adirsingh96/open-pendant/docs/cad/xiao_bottom_silkscreen.png

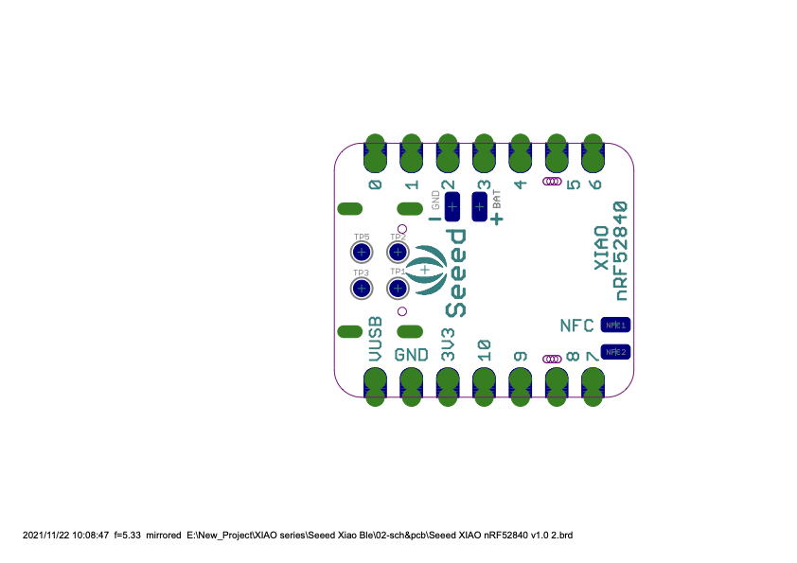
docs/cad/xiao_bottom_silkscreen.png
