adirsingh96/open-pendant/docs/img/proto-bat-window.jpg

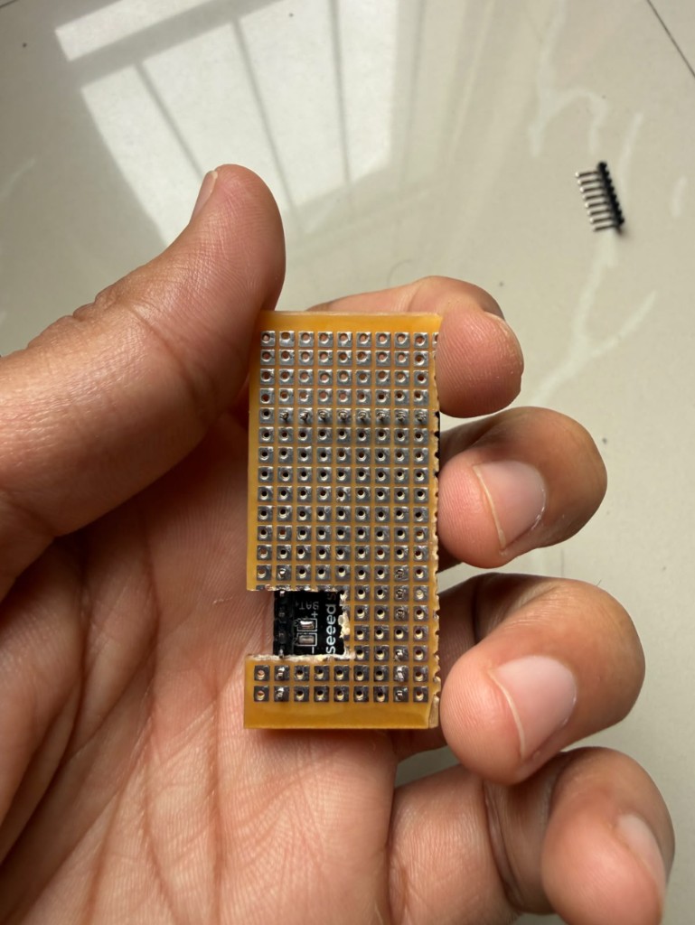
docs/img/proto-bat-window.jpg
