adirsingh96/open-pendant/docs/img/proto-front.jpg

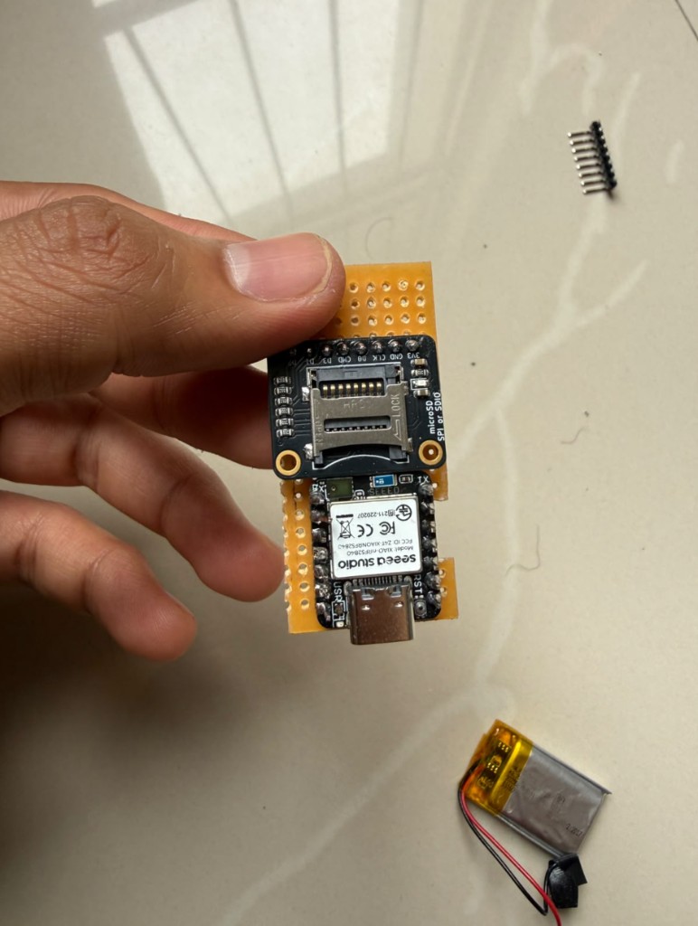
docs/img/proto-front.jpg
