adirsingh96/open-pendant/docs/img/proto-lipo.jpg

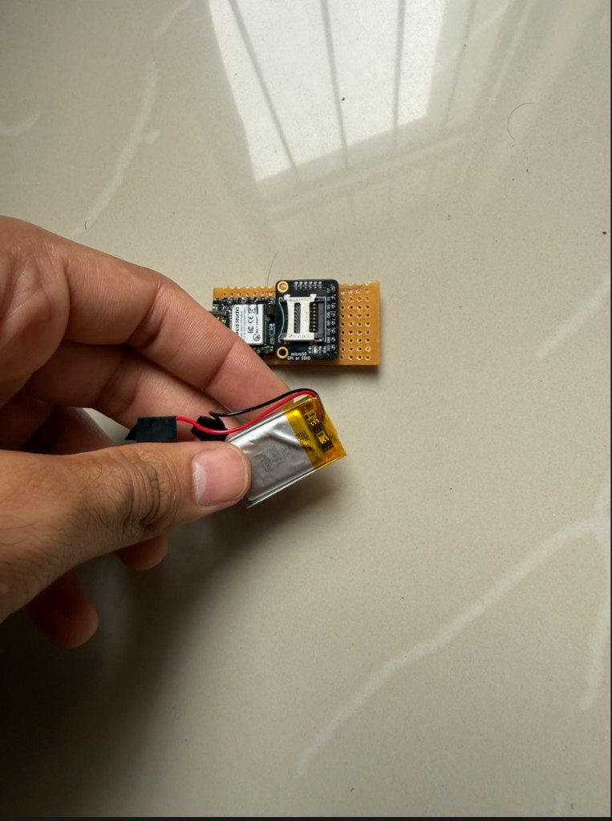
docs/img/proto-lipo.jpg
