adirsingh96/open-pendant/docs/launch/poster.jpg

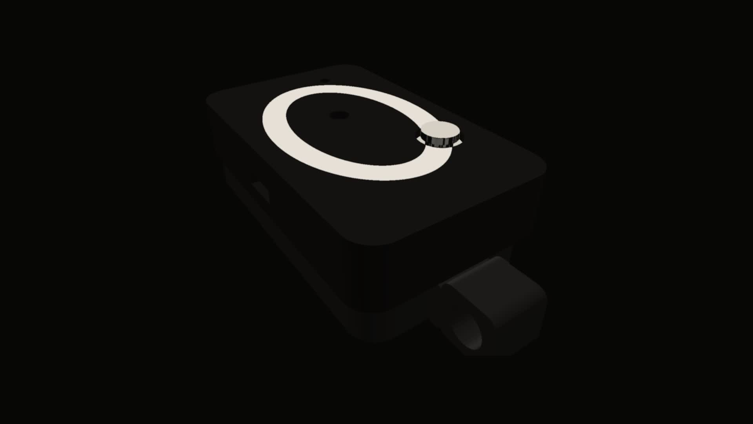
docs/launch/poster.jpg
