adirsingh96/open-pendant/hardware/openpendant_carrier/openpendant_carrier/output/back.png

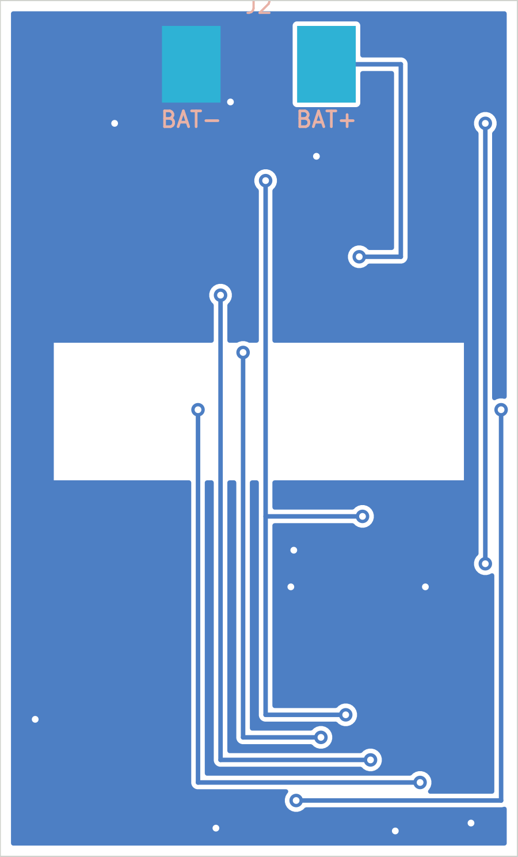
hardware/openpendant_carrier/openpendant_carrier/output/back.png
