adirsingh96/open-pendant/hardware/openpendant_carrier/openpendant_carrier/output/front.png

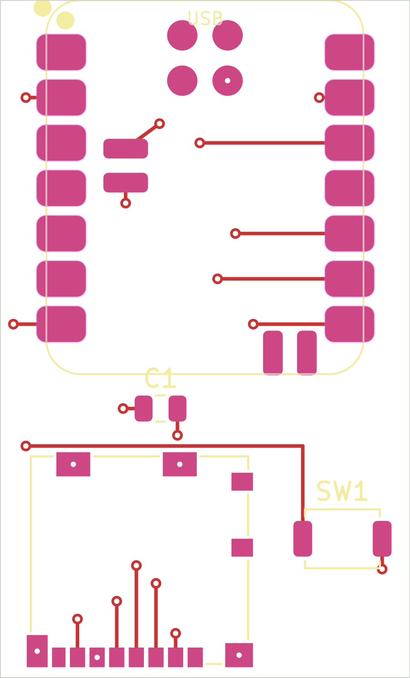
hardware/openpendant_carrier/openpendant_carrier/output/front.png
