adirsingh96/open-pendant/docs/cad/pendant_case_back.stl

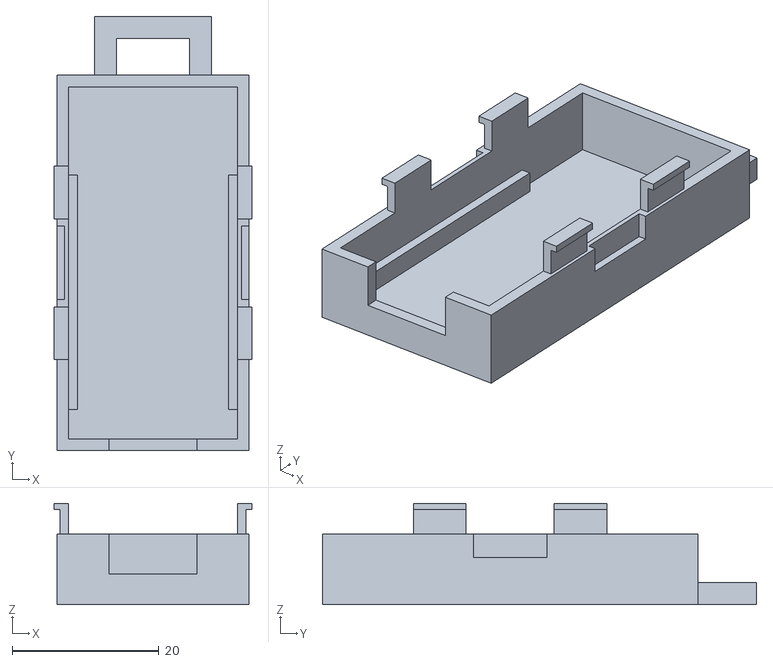
[picture p11: CAD file, 2026-09-06]
docs/cad/pendant_case_back.stl
27.0 x 59.2 x 13.8
