adirsingh96/open-pendant/hardware/openpendant_carrier/cad/character/character_front.3mf

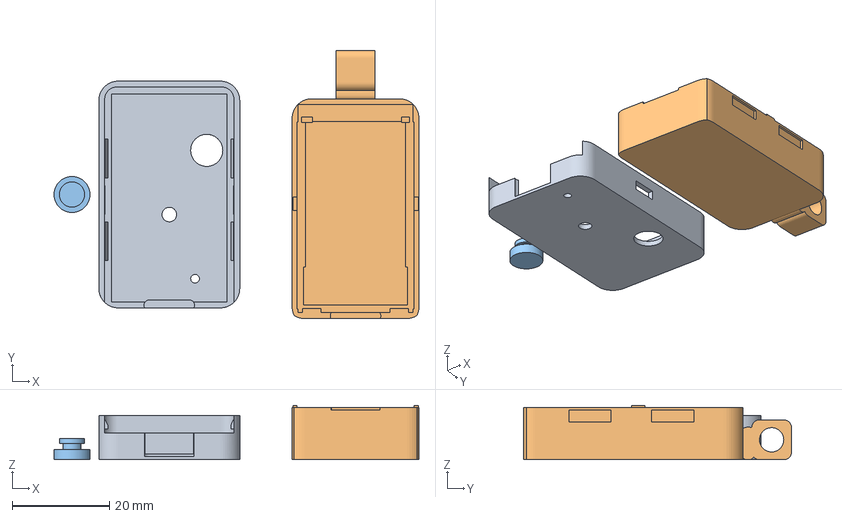
[picture p12: CAD file, 2026-10-27]
hardware/openpendant_carrier/cad/character/character_front.3mf
75.1 x 55.2 x 11.2 mm
Front shell
character_back.stl
character_button_hat.stl
