adirsingh96/open-pendant/docs/cad/pendant_case_print.stl

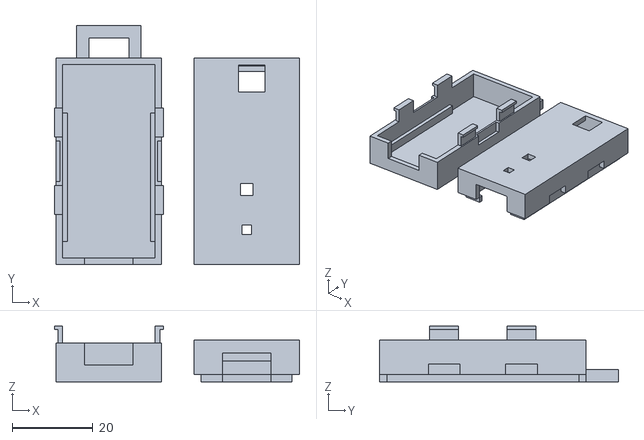
[picture p13: CAD file, 2026-09-06]
docs/cad/pendant_case_print.stl
60.8 x 59.2 x 13.8
