adirsingh96/open-pendant/hardware/openpendant_carrier/cad/character/character_button_hat.stl

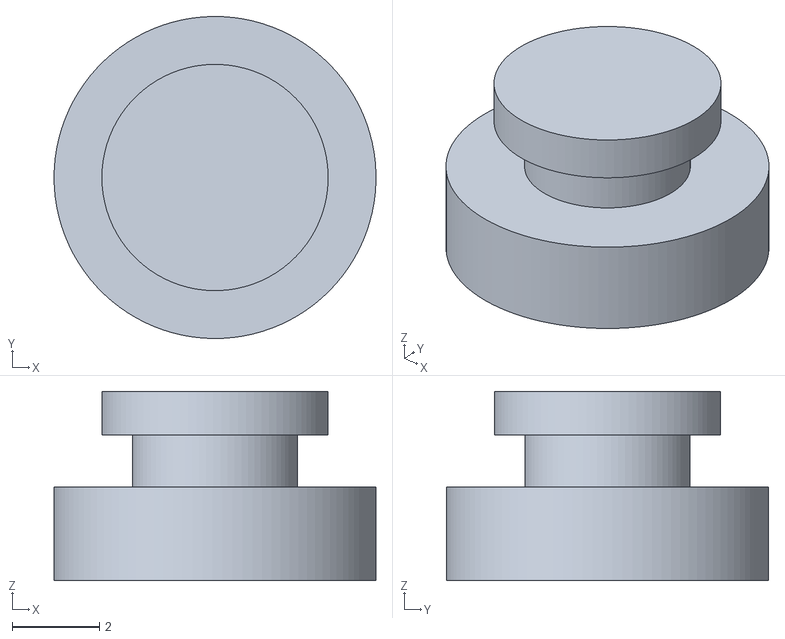
[picture p14: CAD file, 2026-10-27]
hardware/openpendant_carrier/cad/character/character_button_hat.stl
7.40 x 7.40 x 4.35
