adirsingh96/open-pendant/docs/cad/pendant_case_front.stl

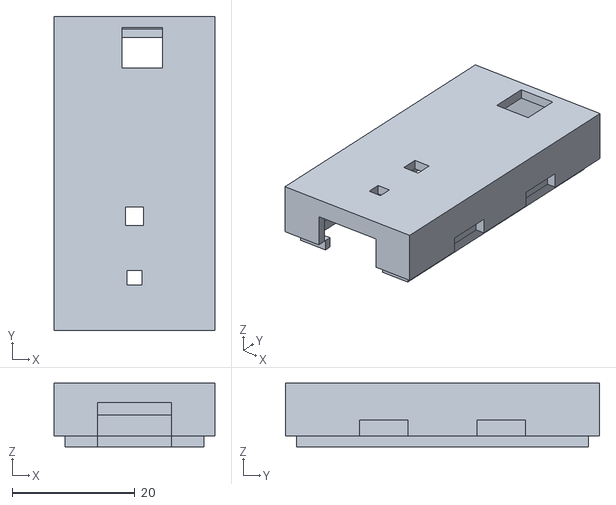
[picture p15: CAD file, 2026-09-06]
docs/cad/pendant_case_front.stl
26.2 x 51.2 x 10.4
