adirsingh96/open-pendant/hardware/openpendant_carrier/cad/character/character_back.stl

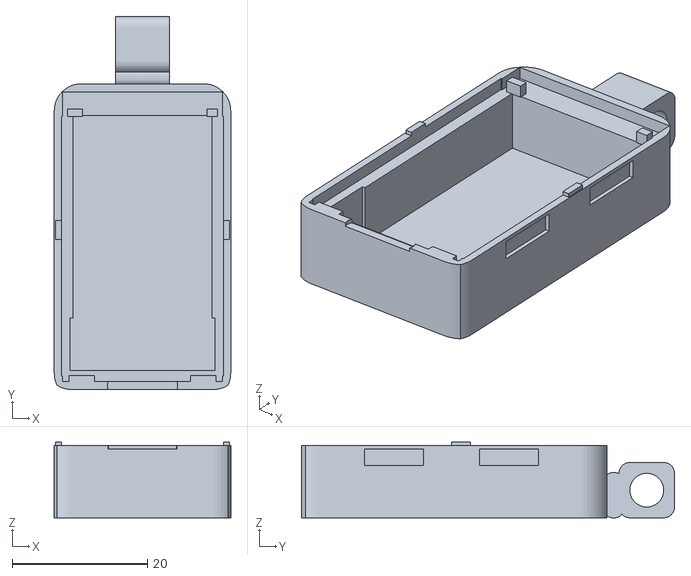
[picture p16: CAD file, 2026-10-27]
hardware/openpendant_carrier/cad/character/character_back.stl
26.1 x 55.2 x 11.2
