adirsingh96/open-pendant/(list of files, cad)

Other CAD files:
hardware/openpendant_carrier/cad/character/character_case.f3d
hardware/openpendant_carrier/cad/character/character_front.stl
