adirsingh96/open-pendant/hardware/openpendant_carrier/openpendant_carrier/openpendant_carrier.kicad_pcb

## KiCad design hardware/openpendant_carrier/openpendant_carrier/openpendant_carrier.kicad_pcb (2026-10-27)

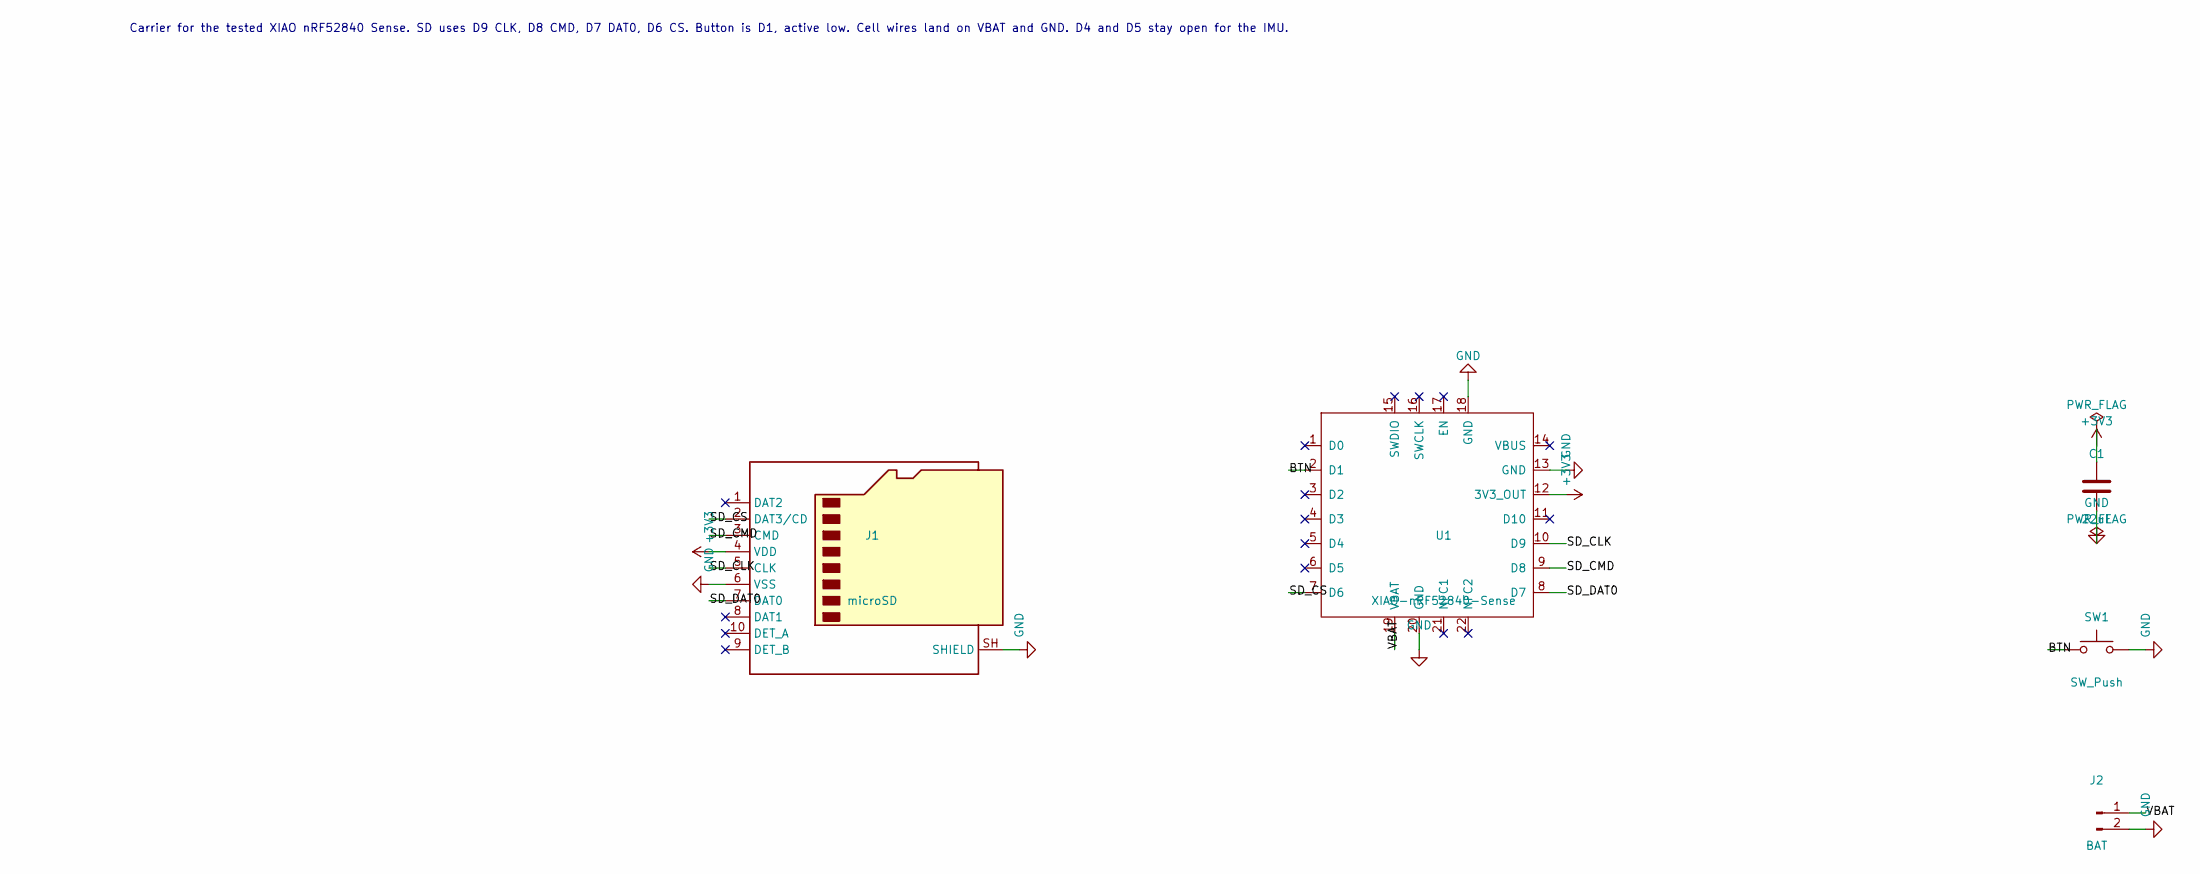
[picture p17: schematic openpendant_carrier.kicad_sch]

Parts:
C1: 22uF; C_0805_2012Metric
J1: microSD; microSD_HC_Molex_104031-0811
J2: BAT; BAT_PADS
SW1: SW_Push; SW_SPST_TS-1088-xR020
U1: XIAO-nRF52840-Sense; XIAO-nRF52840-SMD

Connections:
+3V3: C1.1, J1.4 (VDD), U1.12 (3V3_OUT)
/BTN: SW1.1, U1.2 (D1)
/SD_CLK: J1.5 (CLK), U1.10 (D9)
/SD_CMD: J1.3 (CMD), U1.9 (D8)
/SD_CS: J1.2 (DAT3/CD), U1.7 (D6)
/SD_DAT0: J1.7 (DAT0), U1.8 (D7)
/VBAT: J2.1, U1.19 (VBAT)
GND: C1.2, J1.6 (VSS), J1.SH (SHIELD), J2.2, SW1.2, U1.13 (GND), U1.18 (GND), U1.20 (GND)

Notes on the sheet:
Carrier for the tested XIAO nRF52840 Sense. SD uses D9 CLK, D8 CMD, D7 DAT0, D6 CS. Button is D1, active low. Cell wires land on VBAT and GND. D4 and D5 stay open for the IMU.

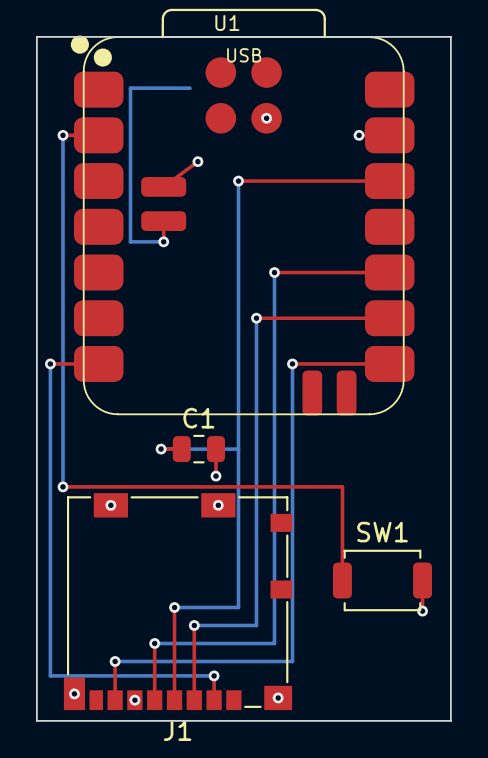
[picture p18: board openpendant_carrier.kicad_pcb from above]

Board: 2 copper layers, 23.0 x 38.0 mm, 5 parts (0 on the bottom side), 8 nets.
