adirsingh96/open-pendant/(commit log)

2026-08-19 Add armed all-day STT, diarization, VAD calibrate, and battery status.
    Arm once with chunked VAD-gated OpenAI (sessions, spend, Hindi/English), optional voice enrollment, and mic calibration for neck-mic distance. Docs drop Omi mentions and describe the current host flow.
2026-08-21 Add Cursor voice commands and in-app spoken notes.
    Pendant utterances can paste into Composer, and “take a note” saves locally on Home without Google Calendar.
2026-08-30 Add meetings, hold-to-talk notes, and more reliable STT.
    Single click starts or ends a meeting, a long press captures a private note, and the LED shows idle green, meeting red, and note blue. OpenAI uploads retry after a dropped connection, and failed chunks no longer clutter Home.
    [main.c]
2026-08-30 Add liquid-glass host UI, device-mic fallback, and meeting detail.
    Use Mac/iPhone audio when the pendant is disconnected, keep necklace-only meetings from switching mics, and restyle the app with readable settings and developer screens.
2026-08-30 Redesign app UI to a dark editorial system with pendant pairing flow
    Replaces the light liquid-glass look with a warm near-black canvas, one
    orange accent, and Instrument Sans throughout. Adds a visual pendant
    connect flow (sonar scan, success/failure states), an aurora-orb live
    recording screen with a Siri-style edge glow, tabbed Library/Settings,
    and a phone-density text scale so sizing reads right on iOS, not just
    on a resized Mac window.
2026-09-02 Keep in-app notes running while the pendant is connected, and use a fixed meeting VAD floor for distant talkers.
    Phone Capture was ending as soon as BLE reported noteHeld false. Meetings now gate at 1e9 / 0.5s of speech instead of wearer calibrate, and long Saaras phrases split on OpenAI speaker turns.
2026-09-06 Add microSD SPI support, assembly guide, and wiring diagram.
    Map SD to D9/D8/D7/D6 with UART0 freed for CS/MISO, expose a Developer
    SD self-test over BLE, and document the full pendant circuit in README
    plus docs/pendant_assembly.html.
2026-10-27 Publish the carrier board, Orbit O case, and offline SD sync so a clone can be built.
    The gerbers, character-case STLs, and assembly notes are the files to order and print. Meetings keep one Saaras transcript.
2026-10-28 Remove the unused case models so a clone only has the Orbit O shell.
    The early strip case and the twin-ear generator are gone. Print files and the assembly notes now point at cad/character.
2026-10-28 Show the printed case and the meeting screens in the README.
    A clone can see the Orbit O shell and what the app does before building.
2026-10-28 Put the launch film at the top of the README.
    GitHub drops a video tag, so the frame links to the film.
